huxiangjs/hoozz_play_esp8266_switch/PCB/PCB1/PCB1.pdf

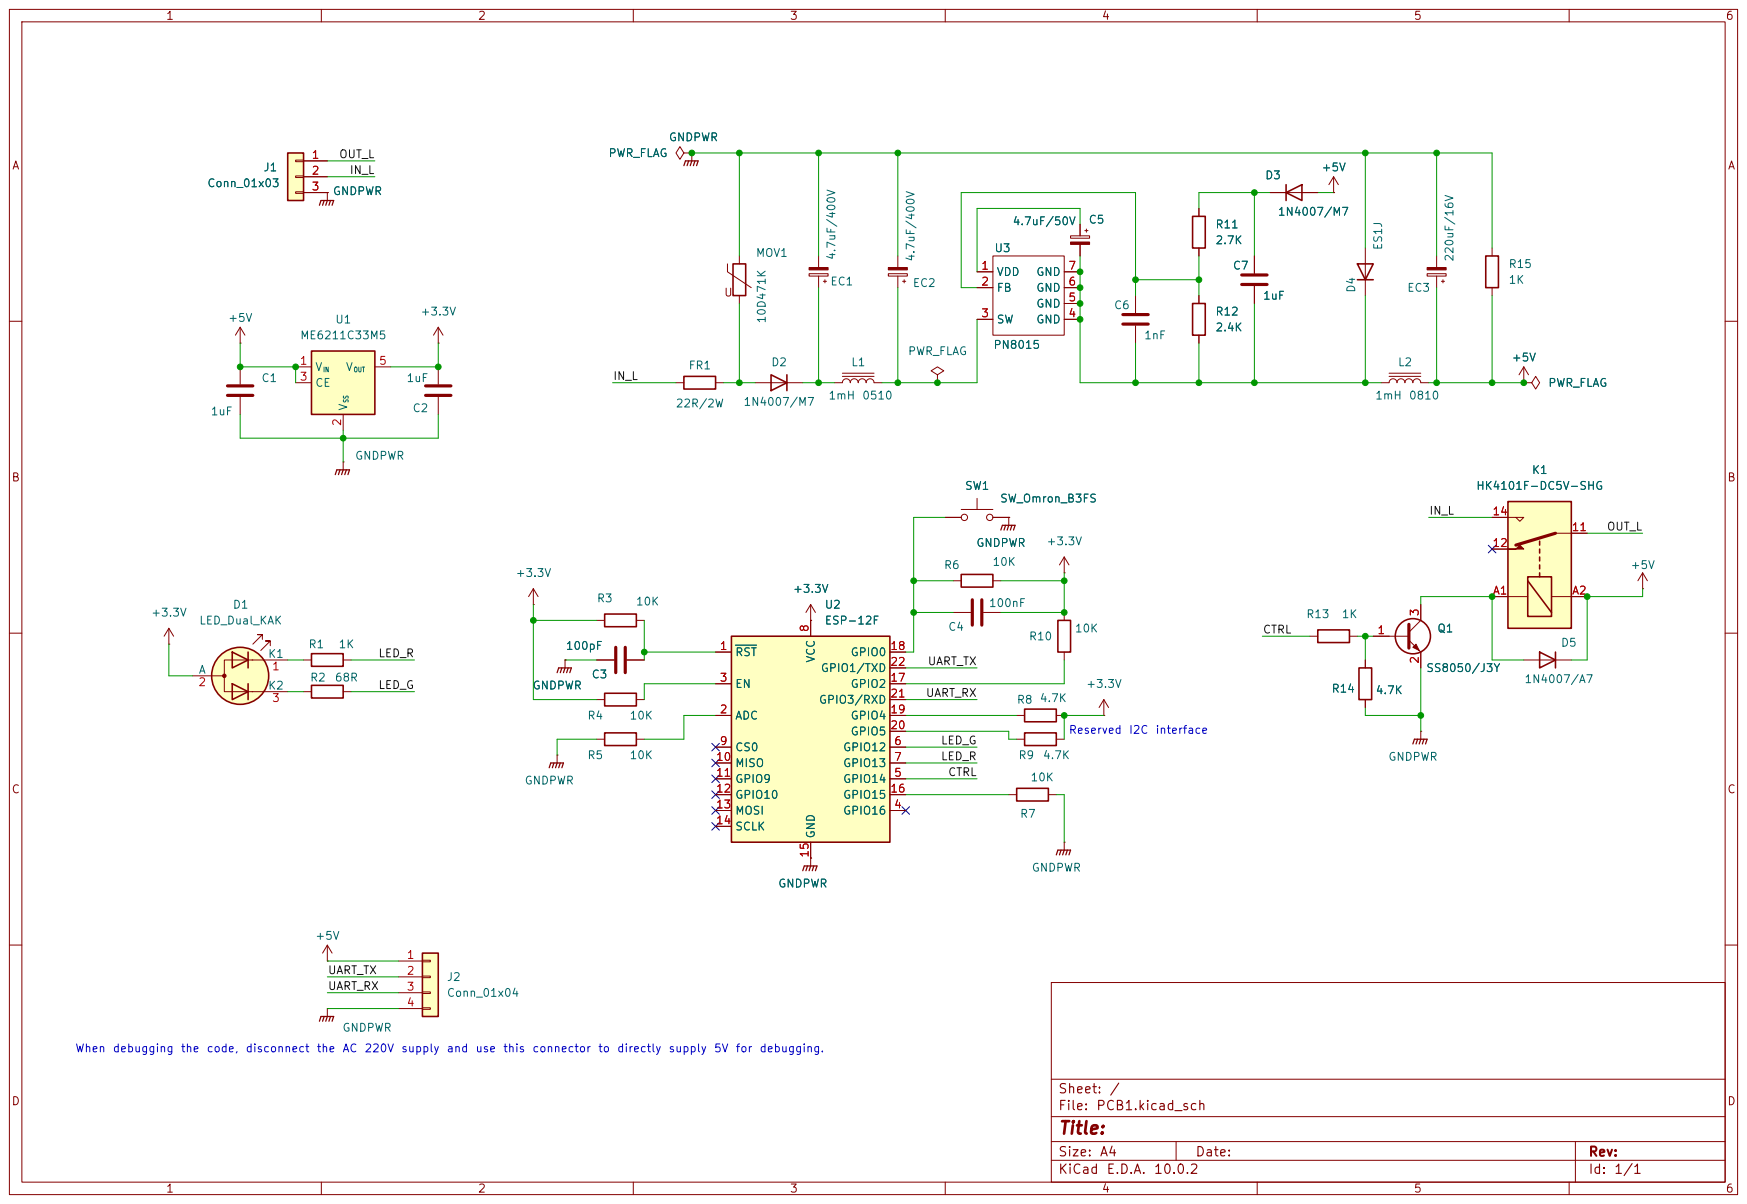
[picture p2: page 1]

Size: A4 | Rev:
KiCad E.D.A. 10.0.2 | Id: 1/1
