huxiangjs/hoozz_play_esp8266_switch/PCB/PCB1/PCB1.kicad_pcb

## KiCad design PCB/PCB1/PCB1.kicad_pcb (2026-11-09)

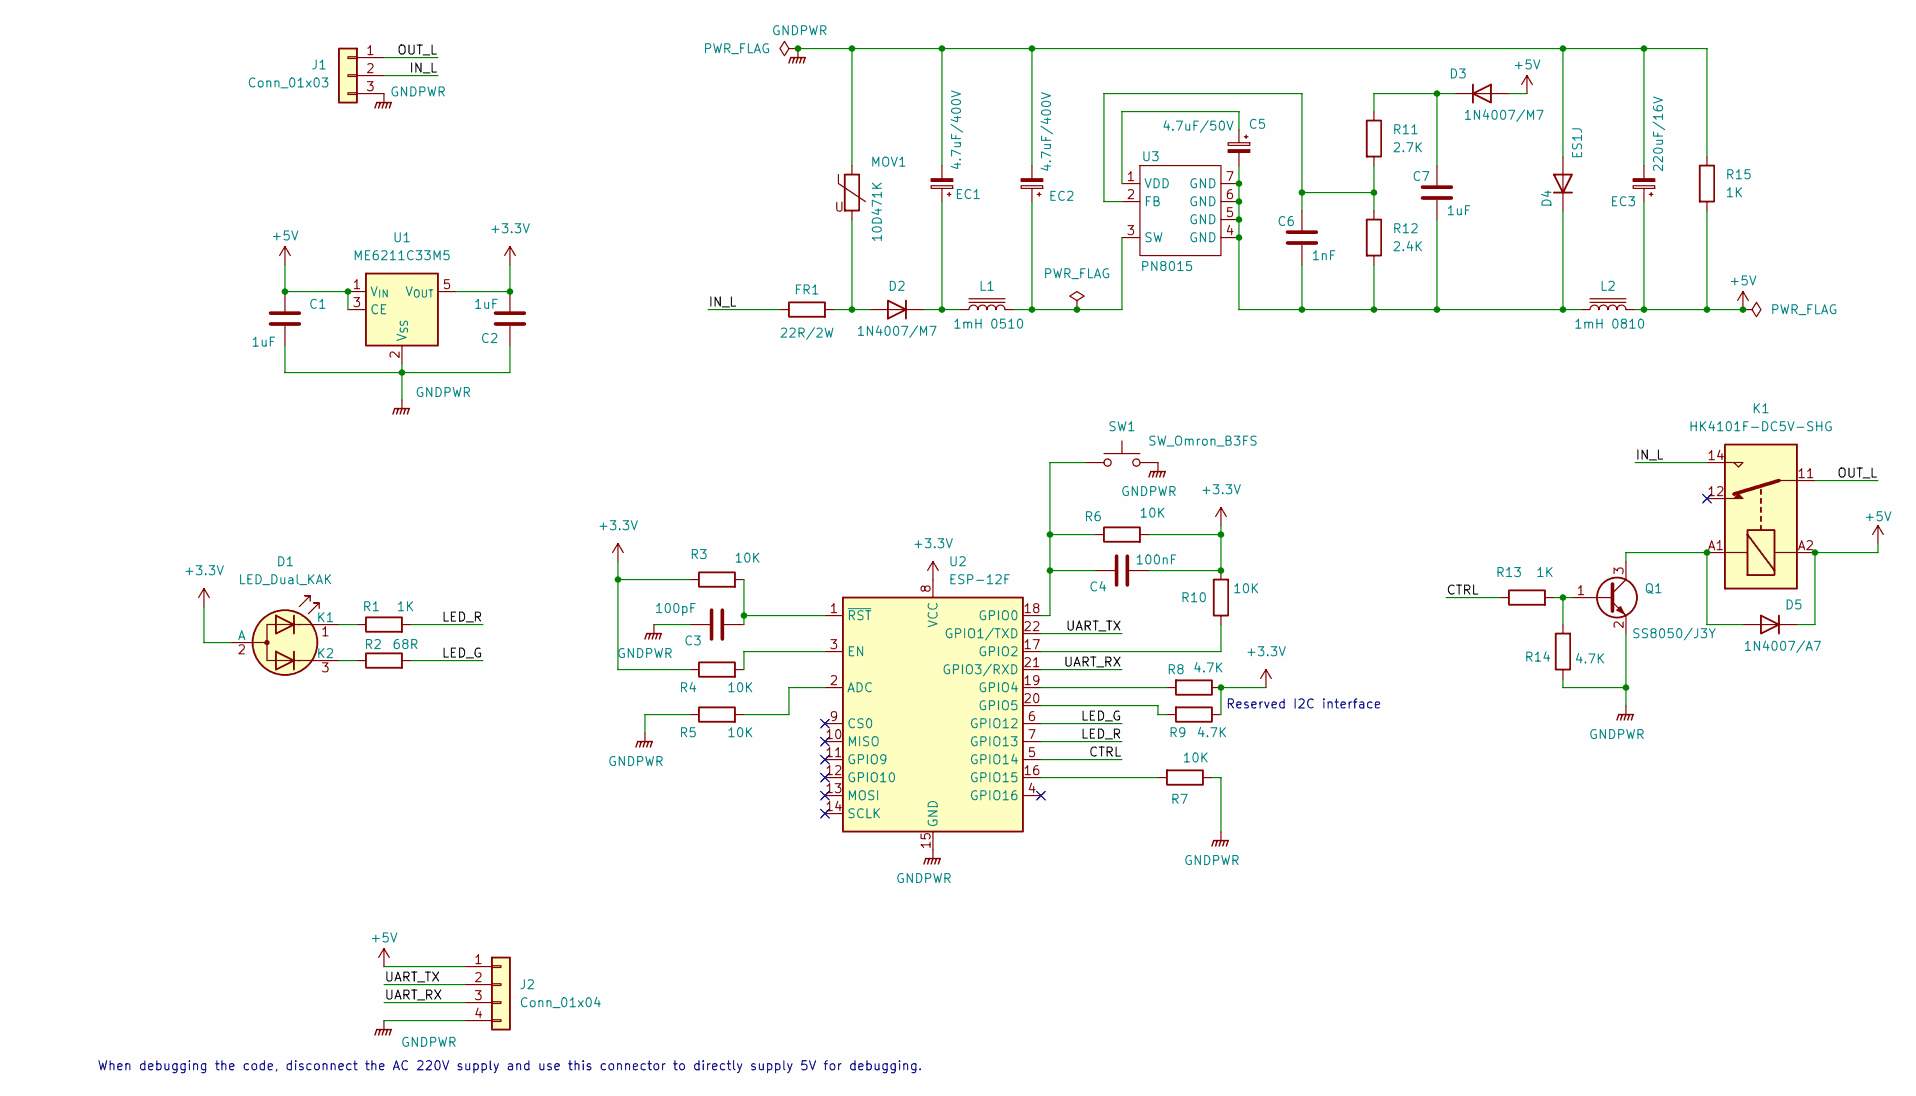
[picture p3: schematic PCB1.kicad_sch]

Parts:
C1, C2, C7: 1uF; C_0603_1608Metric
C3: 100pF; C_0603_1608Metric
C4: 100nF; C_0603_1608Metric
C5: 4.7uF/50V; CP_Radial_D4.0mm_P2.00mm
C6: 1nF; C_0603_1608Metric
D1: LED_Dual_KAK; LED_LiteOn_LTST-S326
D2, D3: 1N4007/M7; D_SMA
D4: ES1J; D_SMA
D5: 1N4007/A7; D_SOD-123F
EC1, EC2: 4.7uF/400V; CP_Radial_D8.0mm_P3.50mm
EC3: 220uF/16V; CP_Radial_D6.3mm_P2.50mm
FR1: 22R/2W; R_Axial_DIN0614_L14.3mm_D5.7mm_P15.24mm_Horizontal
J1: Conn_01x03; PhoenixContact_MCV_1,5_3-G-5.08_1x03_P5.08mm_Vertical
J2: Conn_01x04; PinHeader_1x04_P1.27mm_Vertical
K1: HK4101F-DC5V-SHG; Relay_HK4101F-DC5V-SHG
L1: 1mH 0510; L_Axial_L14.0mm_D4.5mm_P5.08mm_Vertical_Fastron_LACC
L2: 1mH 0810; L_Radial_D8.7mm_P5.00mm_Fastron_07HCP
MOV1: 10D471K; RV_Disc_D12mm_W4.5mm_P7.5mm
Q1: SS8050/J3Y; SOT-23
R1, R13, R15: 1K; R_0603_1608Metric
R2: 68R; R_0603_1608Metric
R3, R4, R5, R6, R7, R10: 10K; R_0603_1608Metric
R8, R9, R14: 4.7K; R_0603_1608Metric
R11: 2.7K; R_0603_1608Metric
R12: 2.4K; R_0603_1608Metric
SW1: SW_Omron_B3FS; SW_SPST_Omron_B3FS-100xP
U1: ME6211C33M5; SOT-23-5
U2: ESP-12F; ESP-12E
U3: PN8015; SOP-7_4.9x6mm_P1.27mm

Connections:
+3.3V: C2.2, C4.2, D1.2 (A), R3.1, R4.1, R6.2, R8.1, R9.1, R10.2, U1.5 (V_{OUT}), U2.8 (VCC)
+5V: C1.1, D3.2 (A), D5.1 (K), EC3.1, J2.1, K1.A2, L2.2, R15.2, U1.1 (V_{IN}), U1.3 (CE)
/CTRL: R13.1, U2.5 (GPIO14)
/IN_L: FR1.1, J1.2, K1.14
/LED_G: R2.2, U2.6 (GPIO12)
/LED_R: R1.2, U2.7 (GPIO13)
/OUT_L: J1.1, K1.11
/UART_RX: J2.3, U2.21 (GPIO3/RXD)
/UART_TX: J2.2, U2.22 (GPIO1/TXD)
GNDPWR: C1.2, C2.1, C3.1, D4.2 (A), EC1.2, EC2.2, EC3.2, J1.3, J2.4, MOV1.1, Q1.2 (E), R5.1, R7.1, R14.1, R15.1, SW1.2, U1.2 (V_{SS}), U2.15 (GND)
unnamed: D1.1 (K1), R1.1
unnamed: D1.3 (K2), R2.1
unnamed: D2.2 (A), FR1.2, MOV1.2
unnamed: D2.1 (K), EC1.1, L1.1
unnamed: C7.1, D3.1 (K), R11.1
unnamed: C5.2, C6.2, C7.2, D4.1 (K), L2.1, R12.2, U3.4 (GND), U3.5 (GND), U3.6 (GND), U3.7 (GND)
unnamed: D5.2 (A), K1.A1, Q1.3 (C)
unnamed: Q1.1 (B), R13.2, R14.2
unnamed: R5.2, U2.2 (ADC)
unnamed: R4.2, U2.3 (EN)
unnamed: C4.1, R6.1, SW1.1, U2.18 (GPIO0)
unnamed: R10.1, U2.17 (GPIO2)
unnamed: R8.2, U2.19 (GPIO4)
unnamed: R9.2, U2.20 (GPIO5)
unnamed: R7.2, U2.16 (GPIO15)
unnamed: C3.2, R3.2, U2.1 (~RST)
unnamed: C6.1, R11.2, R12.1, U3.2 (FB)
unnamed: EC2.1, L1.2, U3.3 (SW)
unnamed: C5.1, U3.1 (VDD)

Notes on the sheet:
When debugging the code, disconnect the AC 220V supply and use this connector to directly supply 5V for debugging.
Reserved I2C interface

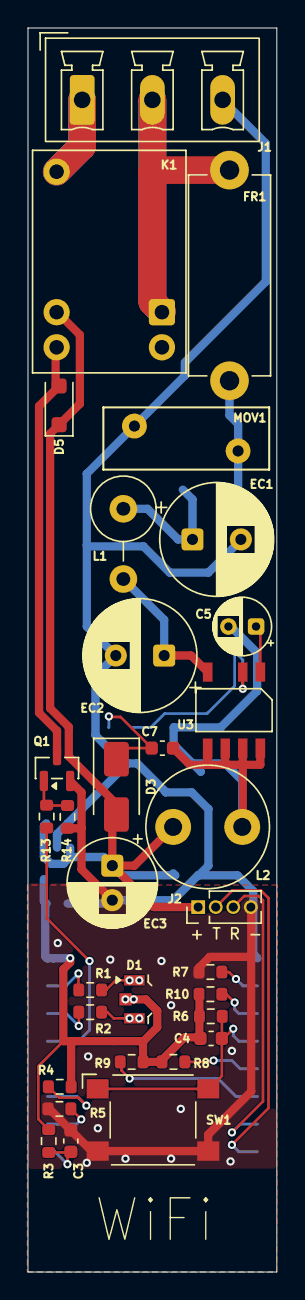
[picture p4: board PCB1.kicad_pcb from above]

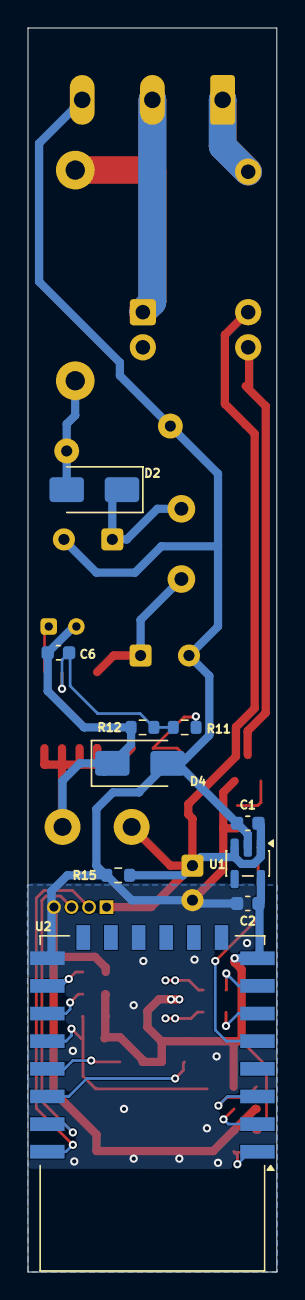
[picture p5: board PCB1.kicad_pcb from below]

Board: 2 copper layers, 18.0 x 90.0 mm, 42 parts (10 on the bottom side), 29 nets.
