huxiangjs/hoozz_play_esp8266_switch/MCU/main/main.c

/*
 * MIT License
 *
 * Copyright (c) 2025 huxiangjs
 *
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
 * THE SOFTWARE IS PROVIDED "AS IS", WITHOUT WARRANTY OF ANY KIND, EXPRESS OR
 * IMPLIED, INCLUDING BUT NOT LIMITED TO THE WARRANTIES OF MERCHANTABILITY,
 * FITNESS FOR A PARTICULAR PURPOSE AND NONINFRINGEMENT. IN NO EVENT SHALL THE
 * AUTHORS OR COPYRIGHT HOLDERS BE LIABLE FOR ANY CLAIM, DAMAGES OR OTHER
 * LIABILITY, WHETHER IN AN ACTION OF CONTRACT, TORT OR OTHERWISE, ARISING FROM,
 * OUT OF OR IN CONNECTION WITH THE SOFTWARE OR THE USE OR OTHER DEALINGS IN THE
 * SOFTWARE.
 */

#include <stdio.h>
#include <string.h>
#include <freertos/FreeRTOS.h>
#include <freertos/task.h>
#include <freertos/queue.h>
#include <esp_system.h>
#include <esp_spi_flash.h>
#include <esp_log.h>
#include <esp_idf_version.h>
#include <nvs_flash.h>
#include <git_version.h>

#include "event_bus.h"
#include "keyboard.h"
#include "store.h"
#include "simple_ctrl.h"
#include "wifi.h"
#include "gpio_led.h"
#include "gpio_switch.h"
#include "hw_version.h"
#include "hlw8032.h"
#include "ota.h"
#include "ota_flash.h"

static const char *TAG = "APP-MAIN";

#define ARRAY_SIZE(a)			(sizeof(a) / sizeof(a[0]))

#define KEYBOARD_GPIO_PIN		GPIO_NUM_0
#define LED_GREEN_GPIO_PIN		GPIO_NUM_12
#define LED_RED_GPIO_PIN		GPIO_NUM_13
#define SWITCH_GPIO_PIN			GPIO_NUM_14

#define LED_GREEN_BRIGHTNESS_MAX	64
#define LED_RED_BRIGHTNESS_MAX		128

/*
 * Hardware version.
 *
 * The version is a simple, monotonically increasing number so that future
 * versions can be added easily (SWITCH_VERSION2, SWITCH_VERSION3, ...).
 * The app queries this via SWITCH_CMD_GET_VERSION to know which features the
 * device supports.
 *
 *   SWITCH_VERSION0 (0) : simple version   - relay control only
 *   SWITCH_VERSION1 (1) : advanced version - relay control + voltage/current/
 *              power measurement + energy metering
 *
 * Keep this comment up to date when a new version is added.
 */
#define SWITCH_VERSION0			0
#define SWITCH_VERSION1			1

/* Commands from the app */
#define SWITCH_CMD_SET_STATE		0x00	/* Set the relay on/off state */
#define SWITCH_CMD_GET_STATE		0x01	/* Get the relay on/off state */
#define SWITCH_CMD_GET_VERSION		0x02	/* Get the hardware version */
#define SWITCH_CMD_GET_MEASURE		0x03	/* Get voltage/current/power (VERSION1 only) */
#define SWITCH_CMD_GET_ENERGY		0x04	/* Get energy metering data (VERSION1 only) */

#define SWITCH_RESULT_OK		0x00
#define SWITCH_RESULT_FAIL		0x01

/* Notification types sent to the app */
#define SWITCH_NOTIFY_STATE_CHANGE	0x00	/* Switch state has changed */
#define SWITCH_NOTIFY_MEASURE		0x01	/* Voltage/current/power + energy updated */

/* Interval for pushing the measurement/energy data to the app (ms) */
#define MEASURE_NOTIFY_INTERVAL_MS	1000

/*
 * Fixed measurement data (for the advanced version, to be replaced with the
 * real measured values later).
 * Units:
 *   Voltage: 0.001V
 *   Current: 0.001A
 *   Power:   0.001W
 *   Energy:  0.001kWh
 */
static uint32_t measure_voltage;
static uint32_t measure_current;
static uint32_t measure_power;
static uint32_t measure_energy;

static bool config_mode;
static QueueHandle_t led_queue;
static uint8_t switch_on;
static uint8_t hardware_version;

static void app_show_info(void)
{
	int size = esp_get_free_heap_size();

	ESP_LOGI(TAG, "Free heap size: %dbytes", size);
}

static void print_build_info(void)
{
	/*
	 * Version tracking: which commit the firmware was built from (git
	 * branch + short sha, with a "-dirty" marker for uncommitted changes),
	 * when it was built, and which SDK it was built with (ESP_IDF_VERSION
	 * is the SDK release, IDF_VER is the SDK's git describe injected by
	 * the SDK build system). The APP_GIT_* macros are defined in
	 * build/include/git_version.h, generated by the project Makefile
	 * from the git state at build time.
	 */
	ESP_LOGI(TAG, "Build: git %s/%s%s, built %s %s",
		 APP_GIT_BRANCH, APP_GIT_SHA, APP_GIT_DIRTY,
		 __DATE__, __TIME__);
	ESP_LOGI(TAG, "SDK: %d.%d.%d (%s)",
		 ESP_IDF_VERSION_MAJOR, ESP_IDF_VERSION_MINOR, ESP_IDF_VERSION_PATCH,
		 IDF_VER);
}

static void print_chip_info(void)
{
	/* Print chip information */
	esp_chip_info_t chip_info;

	esp_chip_info(&chip_info);
	ESP_LOGI(TAG, "This is ESP8266 chip with %d CPU cores, WiFi, silicon revision %d, %dMB %s flash",
		 chip_info.cores, chip_info.revision, spi_flash_get_chip_size() / (1024 * 1024),
		 (chip_info.features & CHIP_FEATURE_EMB_FLASH) ? "embedded" : "external");
}

static void app_led_set_step(char step)
{
	xQueueSend(led_queue, (void *)&step, (TickType_t)0);
}

/* Write a 32-bit value to the buffer in little-endian order */
static void put_u32_le(char *buffer, uint32_t value)
{
	buffer[0] = (value >> 0) & 0xff;
	buffer[1] = (value >> 8) & 0xff;
	buffer[2] = (value >> 16) & 0xff;
	buffer[3] = (value >> 24) & 0xff;
}

/* Notify the app that the switch state has changed */
static void app_notify_state_change(void)
{
	char buffer[2];

	buffer[0] = SWITCH_NOTIFY_STATE_CHANGE;
	buffer[1] = switch_on;
	simple_ctrl_notify(buffer, sizeof(buffer));
}

/*
 * Push the latest measurement/energy data to the app.
 * Payload: [type(1B), voltage(4B), current(4B), power(4B), energy(4B)],
 * all little-endian. Units: voltage 0.001V, current 0.001A, power 0.001W,
 * energy 0.001kWh.
 */
static void app_notify_measure(void)
{
	char buffer[1 + 16];
	int offs = 1;

	buffer[0] = SWITCH_NOTIFY_MEASURE;

	put_u32_le(buffer + offs, measure_voltage);
	offs += 4;
	put_u32_le(buffer + offs, measure_current);
	offs += 4;
	put_u32_le(buffer + offs, measure_power);
	offs += 4;
	put_u32_le(buffer + offs, measure_energy);
	offs += 4;

	simple_ctrl_notify(buffer, offs);
}

/*
 * Periodically push the measurement/energy data to the app so it can stay
 * in sync (advanced version only, started in app_main).
 */
static void app_measure_task(void *arg)
{
	for (;;) {
		vTaskDelay(pdMS_TO_TICKS(MEASURE_NOTIFY_INTERVAL_MS));
		app_notify_measure();
	}
}

static int app_ctrl_request(char *buffer, int buf_offs, int vaild_size, int buff_size)
{
	if (vaild_size < 1) {
		ESP_LOGE(TAG, "Information command is incorrect");
		return -1;
	}

	if (buff_size - buf_offs < 2)
		goto nomem_err;

	switch (buffer[buf_offs]) {
	case SWITCH_CMD_SET_STATE:		/* Set the relay state */
		if (vaild_size != 2)
			goto lllegal_err;
		switch_on = buffer[buf_offs + 1] ? 1 : 0;
		gpio_switch_set_state(switch_on);
		ESP_LOGI(TAG, "Switch state has been set to %s",
				switch_on ? "on" : "off");
		/*
		 * Notify all connected apps (including the one that made the
		 * request) so every client stays in sync.
		 */
		app_notify_state_change();
		buffer[buf_offs + 1] = SWITCH_RESULT_OK;
		return 2;
	case SWITCH_CMD_GET_STATE:		/* Get the relay state */
		if (buff_size - buf_offs < 3)
			goto nomem_err;
		buffer[buf_offs + 1] = SWITCH_RESULT_OK;
		buffer[buf_offs + 2] = switch_on;
		return 3;
	case SWITCH_CMD_GET_VERSION:	/* Get the hardware version */
		if (buff_size - buf_offs < 3)
			goto nomem_err;
		buffer[buf_offs + 1] = SWITCH_RESULT_OK;
		buffer[buf_offs + 2] = hardware_version;
		return 3;
	case SWITCH_CMD_GET_MEASURE:	/* Get voltage/current/power (VERSION1 only) */
		if (hardware_version != SWITCH_VERSION1) {
			buffer[buf_offs + 1] = SWITCH_RESULT_FAIL;
			return 2;
		}
		if (buff_size - buf_offs < 2 + 12)
			goto nomem_err;
		buffer[buf_offs + 1] = SWITCH_RESULT_OK;
		put_u32_le(buffer + buf_offs + 2, measure_voltage);
		put_u32_le(buffer + buf_offs + 6, measure_current);
		put_u32_le(buffer + buf_offs + 10, measure_power);
		return 2 + 12;
	case SWITCH_CMD_GET_ENERGY:	/* Get energy metering data (VERSION1 only) */
		if (hardware_version != SWITCH_VERSION1) {
			buffer[buf_offs + 1] = SWITCH_RESULT_FAIL;
			return 2;
		}
		if (buff_size - buf_offs < 2 + 4)
			goto nomem_err;
		buffer[buf_offs + 1] = SWITCH_RESULT_OK;
		put_u32_le(buffer + buf_offs + 2, measure_energy);
		return 2 + 4;
	default:
		goto lllegal_err;
	}

	return 0;
nomem_err:
	ESP_LOGE(TAG, "Not enough buffer space");
	return -1;
lllegal_err:
	ESP_LOGE(TAG, "Lllegal command");
	return -1;
}

static void app_led_task(void *arg)
{
	TickType_t xTicksToWait = portMAX_DELAY;
	char step;
	uint8_t red_value = 0;
	uint8_t green_value = 0;
	bool is_green = false;
	char recyclable_step = 0;

	while(1) {
		xQueueReceive(led_queue, &step, xTicksToWait);
		switch (step) {
		case 'r':
			xTicksToWait = portMAX_DELAY;
			green_value = 0;
			red_value = LED_RED_BRIGHTNESS_MAX;
			is_green = false;
			recyclable_step = step;
			break;
		case 'g':
			xTicksToWait = pdMS_TO_TICKS(10000);;
			red_value = 0;
			green_value = LED_GREEN_BRIGHTNESS_MAX;
			is_green = true;
			recyclable_step = step;
			step = 'P';
			break;
		case 'C':
			xTicksToWait = pdMS_TO_TICKS(100);
			red_value = red_value ? 0 : LED_RED_BRIGHTNESS_MAX;
			green_value = red_value ? 0 : LED_GREEN_BRIGHTNESS_MAX;
			recyclable_step = step;
			break;
		case 'P':
			xTicksToWait = portMAX_DELAY;
			green_value = 0;
			recyclable_step = step;
			break;
		case (char)-'P':
			recyclable_step = step;
			if (is_green) {
				xTicksToWait = 0;
				step = 'g';
			} else {
				xTicksToWait = portMAX_DELAY;
			}
			break;
		case 'F':
			gpio_led_set_red_brightness(LED_RED_BRIGHTNESS_MAX);
			gpio_led_set_green_brightness(0);
			vTaskDelay(pdMS_TO_TICKS(40));
			gpio_led_set_red_brightness(0);
			gpio_led_set_green_brightness(LED_GREEN_BRIGHTNESS_MAX);
			vTaskDelay(pdMS_TO_TICKS(40));
			step = recyclable_step;
			break;
		default:
			ESP_LOGW(TAG, "unknow step: %d", step);
		}
		gpio_led_set_red_brightness(red_value);
		gpio_led_set_green_brightness(green_value);
	}

	vQueueDelete(led_queue);
	vTaskDelete(NULL);
}

static bool app_event_notify_callback(struct event_bus_msg *msg)
{
	switch (msg->type) {
	case EVENT_BUS_STARTUP:
		app_led_set_step('r');
		break;
	case EVENT_BUS_WIFI_CONNECTED:
		app_led_set_step('g');
		break;
	case EVENT_BUS_WIFI_DISCONNECTED:
		app_led_set_step('r');
		break;
	case EVENT_BUS_START_SMART_CONFIG:
		app_led_set_step('C');
		break;
	case EVENT_BUS_STOP_SMART_CONFIG:
		config_mode = false;
		break;
	case EVENT_BUS_KEYBOARD:
		if (config_mode || msg->param1 != KEYBOARD_GPIO_PIN)
			break;
		if ((msg->param2 == KEYBOARD_EVENT_SHORT_RELEASE)) {
			// ESP_LOGW(TAG, "Restarting now");
			// fflush(stdout);
			// esp_restart();
			app_led_set_step(-'P');
			switch_on = !switch_on;
			gpio_switch_set_state(switch_on);
			/* Let the app know the state has been changed by the physical button */
			app_notify_state_change();
		}
		/* Smart config */
		if (msg->param2 == KEYBOARD_EVENT_LONG_RELEASE) {
			ESP_LOGI(TAG, "Smart config");
			wifi_smartconfig();
			config_mode = true;
		}
		break;
	case EVENT_BUS_MEASURE_VOLTAGE_UPDATED:
		measure_voltage = msg->param2;
		break;
	case EVENT_BUS_MEASURE_CURRENT_UPDATED:
		measure_current = msg->param2;
		break;
	case EVENT_BUS_MEASURE_POWER_UPDATED:
		measure_power = msg->param2;
		break;
	case EVENT_BUS_MEASURE_ENERGY_UPDATED:
		measure_energy = msg->param2;
		break;
	}

	return false;
}

/* The OTA transports this device supports (url scheme -> callbacks). */
static const struct ota_transport ota_transports[] = {
	{ "hoozz", hoozz_ota_open, hoozz_ota_size, hoozz_ota_read, hoozz_ota_close },
};

void app_main(void)
{
	int ret;
	struct event_bus_msg msg = { EVENT_BUS_STARTUP, 0, 0};
	uint8_t keyboard_gpios[] = { KEYBOARD_GPIO_PIN };

	print_build_info();
	print_chip_info();
	app_show_info();

	hw_version_init();
	hardware_version = (uint8_t)hw_version_get_id();

	ESP_LOGI(TAG, "Hardware version: %u (0=simple, 1=advanced)", hardware_version);

	/* GPIO LED */
	gpio_led_init(LED_RED_GPIO_PIN, LED_GREEN_GPIO_PIN);
	led_queue = xQueueCreate(10, sizeof(char));
	ESP_ERROR_CHECK(led_queue == NULL);
	ESP_ERROR_CHECK(xTaskCreate(app_led_task, "app_led_task", 1024,
			NULL, tskIDLE_PRIORITY + 2, NULL) != pdPASS);

	/* NVS init */
	ESP_ERROR_CHECK(nvs_flash_init());

	/* Enable OTA (after NVS: the ESP-IDF flash backend's first-boot
	 * validation stores its state there) */
	simple_ctrl_ota_enable(APP_GIT_SHA APP_GIT_DIRTY, ota_transports,
			sizeof(ota_transports) / sizeof(ota_transports[0]),
			&esp_idf_ota_flash);

	/* install gpio isr service */
	ESP_ERROR_CHECK(gpio_install_isr_service(0));

	store_init();

	/* Event bus */
	event_bus_init();
	event_bus_register(app_event_notify_callback);
	event_bus_send(&msg);

	/* Switch */
	gpio_switch_init(SWITCH_GPIO_PIN, true);

	/* Keyboard */
	keyboard_init(keyboard_gpios, sizeof(keyboard_gpios));

	/* Wifi */
	wifi_init();

	/* Network ctrl */
	simple_ctrl_init("SWITCH");
	simple_ctrl_set_class_id(CLASS_ID_SWITCH);
	simple_ctrl_request_register(app_ctrl_request);

	/* VERSION1 (advanced): periodically push measurement/energy data to the app */
	if (hardware_version == SWITCH_VERSION1) {
		ret = hlw8032_init(UART_NUM_0);
		if (!ret) {
			ret = xTaskCreate(app_measure_task, "app_measure_task", 1024,
					  NULL, tskIDLE_PRIORITY + 1, NULL);
			ESP_ERROR_CHECK(ret != pdPASS);
		}
	}

	wifi_connect();

	app_show_info();
}
