huxiangjs/hoozz_play_esp8266_switch/(commit log)

2026-11-08 Create the necessary project files
    [partitions.csv]
2026-11-08 Fix the compilation issue
    [main.c]
2026-11-09 Add a switch control
2026-11-09 Add PCB && Update README.md
    [PCB1.kicad_pcb, PCB1.kicad_sch]
2026-11-09 Add a power measurement feature
2026-11-10 Fix the stale build info with incremental builds
    [main.c]
2026-11-14 CI: trim whitespace from the project name before writing ota_file
    The Makefile uses 'PROJECT_NAME := <name>' so the awk extraction
    carries a leading space into the ota_file content (the unquoted zip
    argument dropped it, the quoted echo did not). Strip spaces and
    carriage returns so ota_file holds the bare bin name.
2026-11-14 Add OTA firmware update support
    Port the OTA feature from hoozz_play_esp8266_smart_ir:
    - main.c: enable OTA with the "hoozz" tcp_crypto transport after
    NVS init (the build info logging is already in place)
    - add the ota/ota_flash/tcp_crypto/tiny-AES-c source stubs (the OTA
    core and its encrypted tunnel live in esp32-common)
    - partitions.csv: switch from the single factory partition to the
    dual OTA layout (otadata + ota_0/ota_1, 1MB each)
    - CI: include ota_data_initial.bin in the release zip
    - update the esp32-common submodule to the latest (it brings in the
    OTA core)
    [partitions.csv]
